M-Verduzco/ClockMachineryInCAD/(list of files, cad)

Other CAD files:
01_Sub_10_11_12.prt
10_Ball.prt
11_Bow.prt
12_BowPivot.prt
13_HingeSection.prt
14_HourTube.prt
15_HourPivot.prt
16_WinderPivot.prt
19_SmallShaftCap.prt
1_PendulumPivot.prt
20_SmallShaftCap-Flatted.prt
21_Shaft.prt
22_HingePivot.prt
23_PawlPin.prt
24_HourHand.prt
25_MinuteHand.prt
26_Weight.prt
27_GearSpacer.prt
28_Hanger.prt
29_Winder.prt
2_PendulumRod.prt
31_Drum.prt
32_Ratchet.prt
33_Pawl.prt
34_Shaft.prt
35_RatchetPivot.prt
36_Shaft.prt
37_Escapement.prt
38_Yoke.prt
39_EscapementWheel.prt
3_PendulumHead.prt
40_GearSpacer.prt
41_Gear.prt
42_DoorCatch.prt
43_Gear.prt
44_Gear.prt
45_Gear.prt
46_Gear.prt
47_Gear.prt
48_Gear.prt
49_Gear.prt
4_PendulumBob.prt
50_Gear.prt
51_Gear.prt
52_HangerSpacer.prt
53_HangerSpacerBottom.prt
5_PendulumHead.prt
5_PendulumNut.prt
6_Case.prt
7_Door.prt
8_BaseBoard.prt
9_FrontBoard (1).prt
Sub_pendulo.prt
