M-Verduzco/ClockMachineryInCAD/Planos Originales.pdf

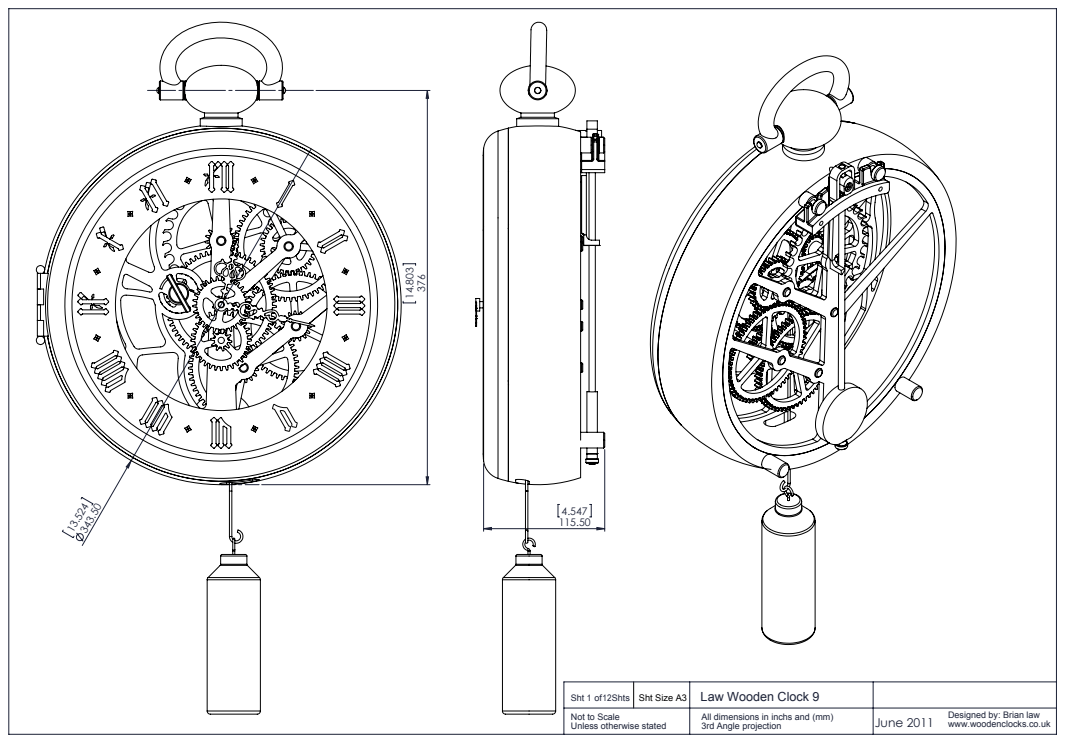
[picture p17: page 1]

1 12 Sht of Shts | Sht Size A3 | Law Wooden Clock 9
Not to Scale Unless otherwise stated | | All dimensions in inchs and (mm) 3rd Angle projection | Designed by: Brian law June 2011 www.woodenclocks.co.uk

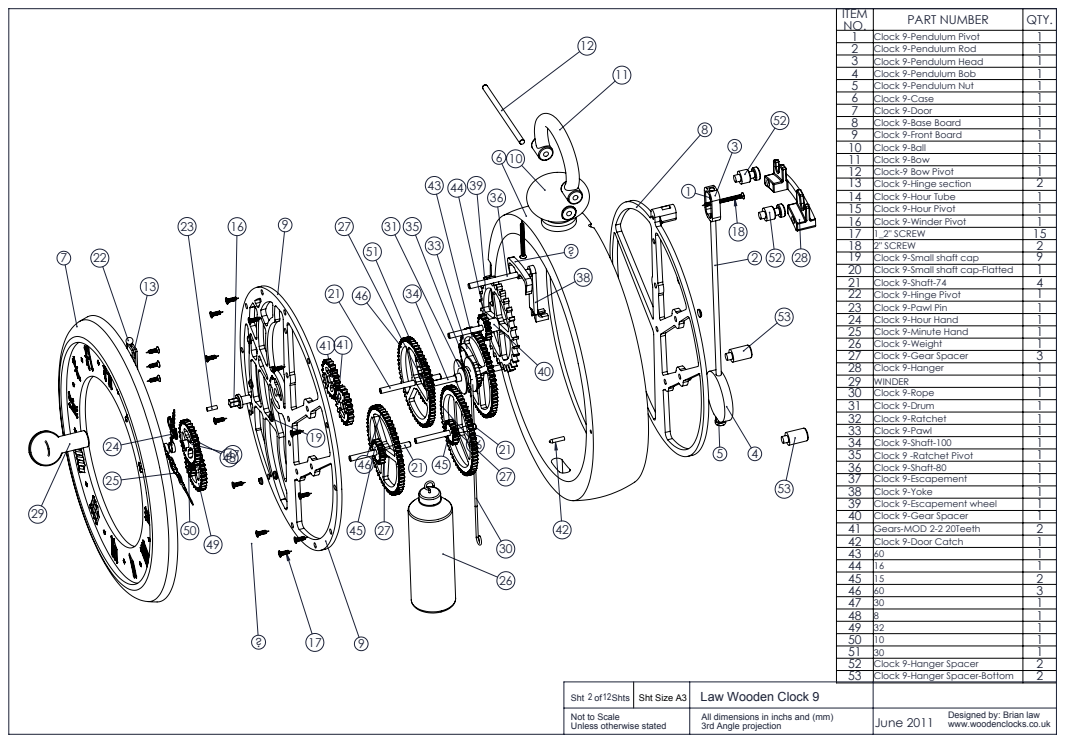
[picture p18: page 2]
PART NUMBER; QTY. 1; Clock 9-Pendulum Pivot; Clock 9-Pendulum Rod; Clock 9-Pendulum Head; Clock 9-Pendulum Bob; Clock 9-Pendulum Nut; Clock 9-Case; Clock 9-Door; Clock 9-Base Board; Clock 9-Front Board

10 | Clock 9-Ball | 1
11 | Clock 9-Bow | 1
12 | Clock-9 Bow Pivot | 1
13 | Clock 9-Hinge section | 2
14 | Clock 9-Hour Tube | 1
15 | Clock 9-Hour Pivot | 1
16 | Clock 9-Winder Pivot | 1
17 | 1_2" SCREW | 15
18 | 2" SCREW | 2
19 | Clock 9-Small shaft cap | 9
20 | Clock 9-Small shaft cap-Flatted | 1
21 | Clock 9-Shaft-74 | 4
22 | Clock 9-Hinge Pivot | 1
23 | Clock 9-Pawl Pin | 1
24 | Clock 9-Hour Hand | 1
25 | Clock 9-Minute Hand | 1
26 | Clock 9-Weight | 1
27 | Clock 9-Gear Spacer | 3
28 | Clock 9-Hanger | 1
29 | WINDER | 1
30 | Clock 9-Rope | 1
31 | Clock 9-Drum | 1
32 | Clock 9-Ratchet | 1
33 | Clock 9-Pawl | 1
34 | Clock 9-Shaft-100 | 1
35 | Clock 9 -Ratchet Pivot | 1
36 | Clock 9-Shaft-80 | 1
37 | Clock 9-Escapement | 1
38 | Clock 9-Yoke | 1
39 | Clock 9-Escapement wheel | 1
40 | Clock 9-Gear Spacer | 1
41 | Gears-MOD 2-2 20Teeth | 2
42 | Clock 9-Door Catch | 1

43 | 60 | 1
44 | 16 | 1
45 | 15 | 2
46 | 60 | 3
47 | 30 | 1
48 | 8 | 1
49 | 32 | 1
50 | 10 | 1
51 | 30 | 1
52 | Clock 9-Hanger Spacer | 2
53 | Clock 9-Hanger Spacer-Bottom | 2

2 12 | | Law Wooden Clock 9

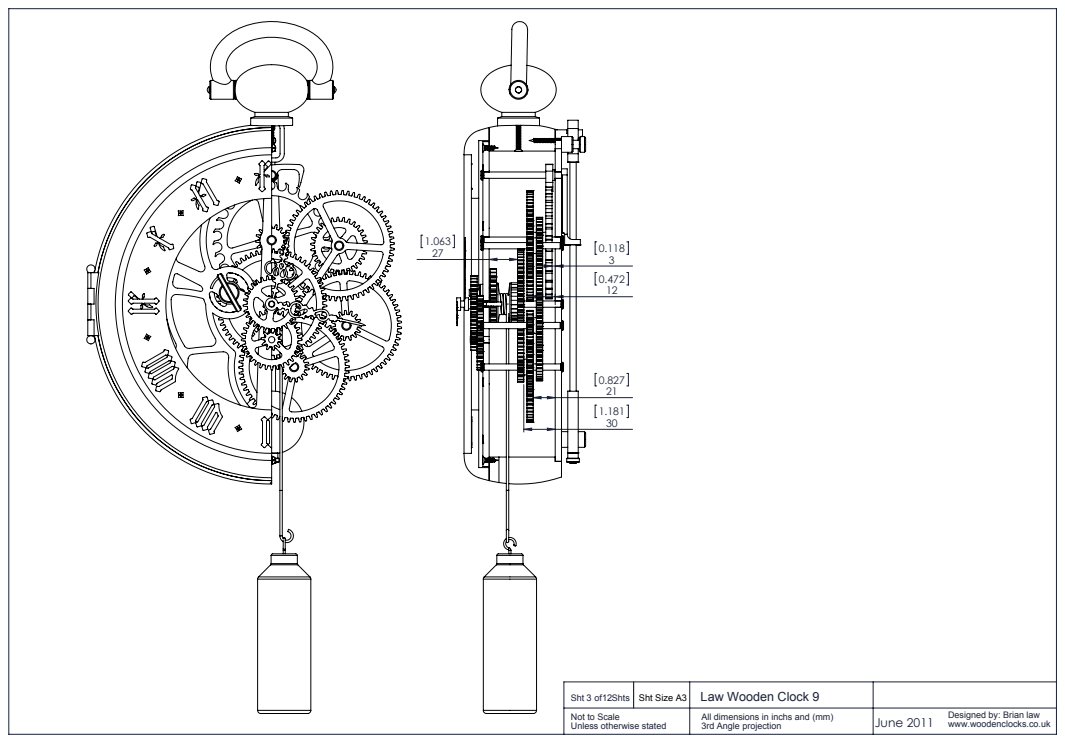
[picture p19: page 3]
Law Wooden Clock 9

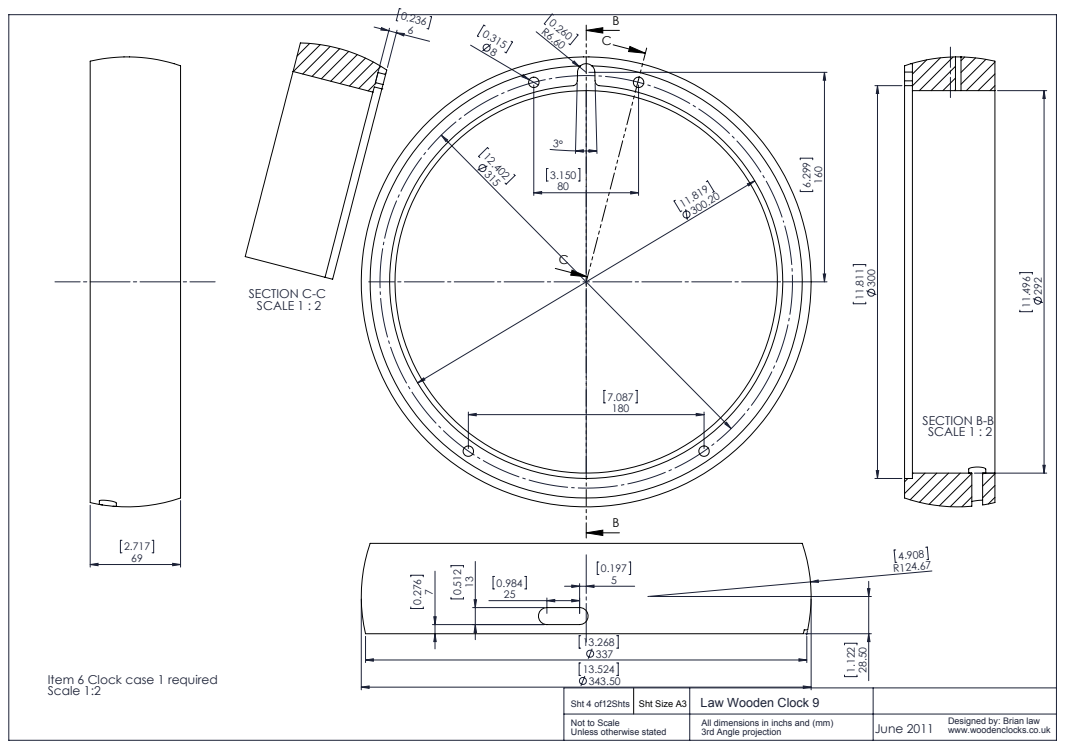
[picture p20: page 4]
SECTION B-B SCALE 1 : 2; SECTION C-C SCALE 1 : 2; Law Wooden Clock 9

Item 6 Clock case 1 required
Scale 1:2

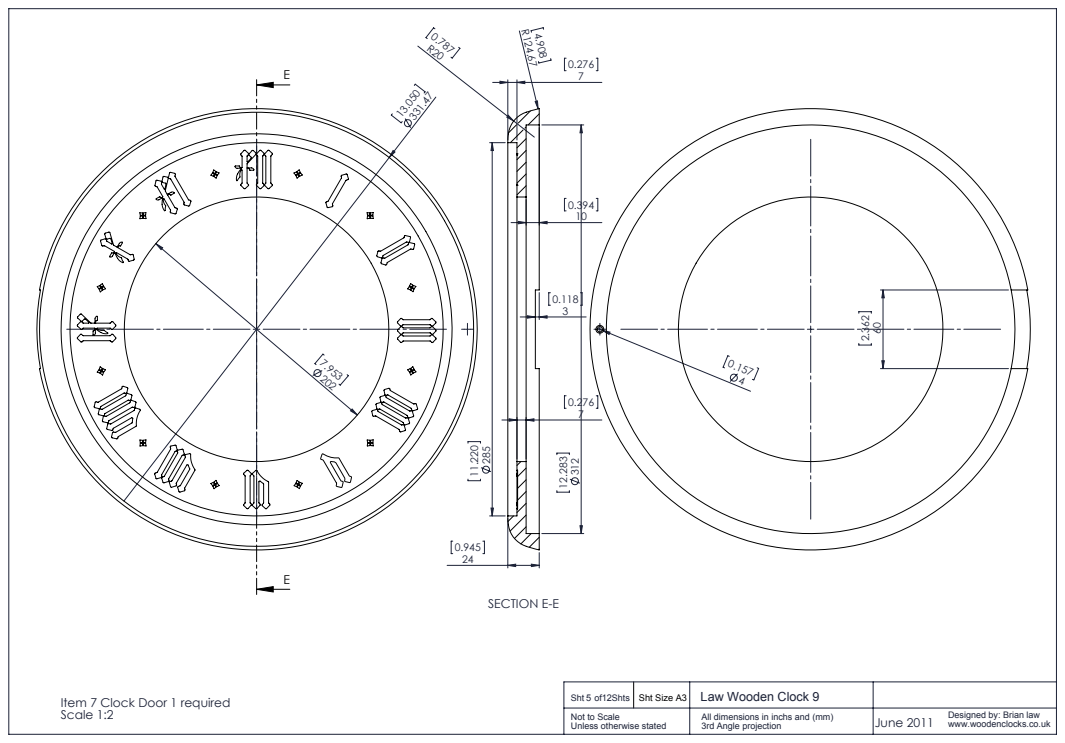
[picture p21: page 5]
SECTION E-E; Law Wooden Clock 9

Item 7 Clock Door 1 required
Scale 1:2

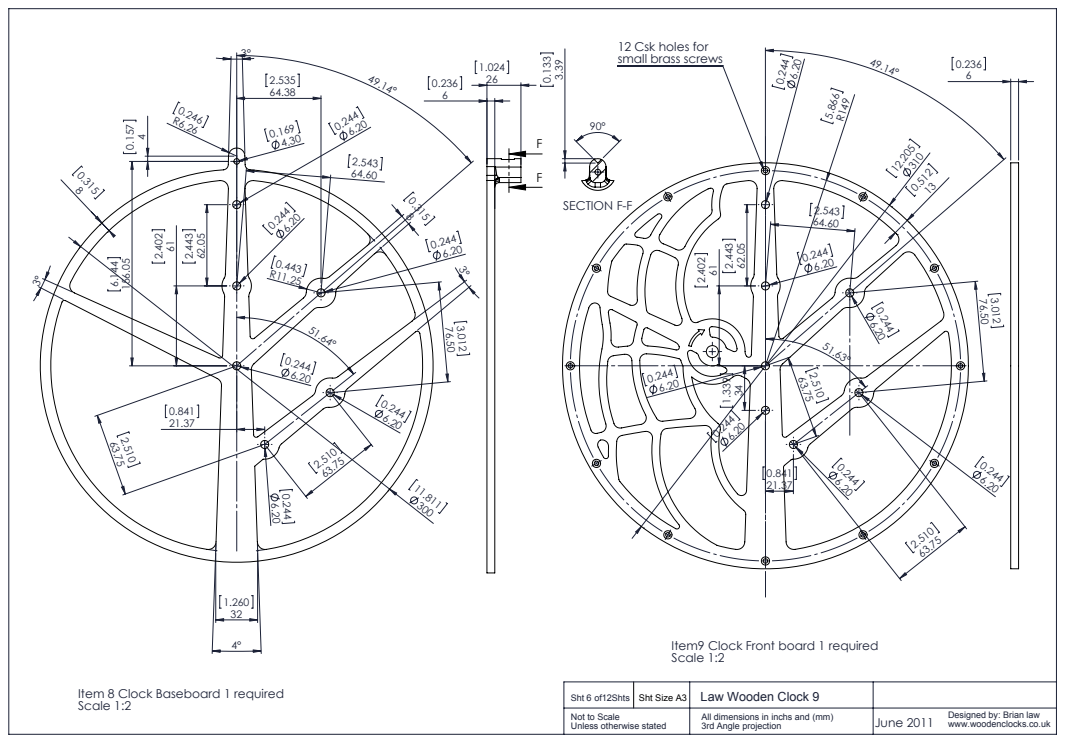
[picture p22: page 6]
SECTION F-F; small brass screws; Law Wooden Clock 9

12 Csk holes for

Item9 Clock Front board 1 required
Scale 1:2

Item 8 Clock Baseboard 1 required

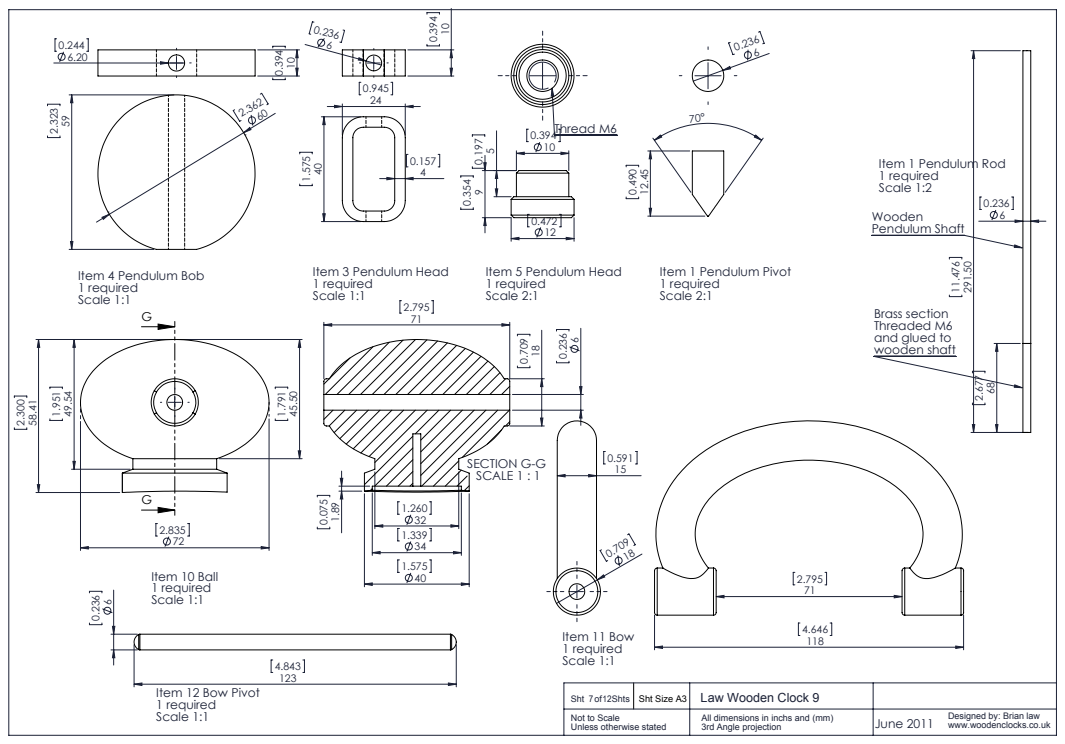
[picture p23: page 7]
Thread M6; SECTION G-G SCALE 1 : 1; Item 10 Ball 1 required Scale 1:1; Item 11 Bow 1 required Scale 1:1

Item 1 Pendulum Rod
1 required
Scale 1:2
Wooden
Pendulum Shaft

Item 4 Pendulum Bob
Scale 1:1

Item 3 Pendulum Head

Item 5 Pendulum Head
Scale 2:1

Item 1 Pendulum Pivot

Brass section
Threaded M6
and glued to
wooden shaft

7 12 Item 12 Bow Pivot

Law Wooden Clock 9

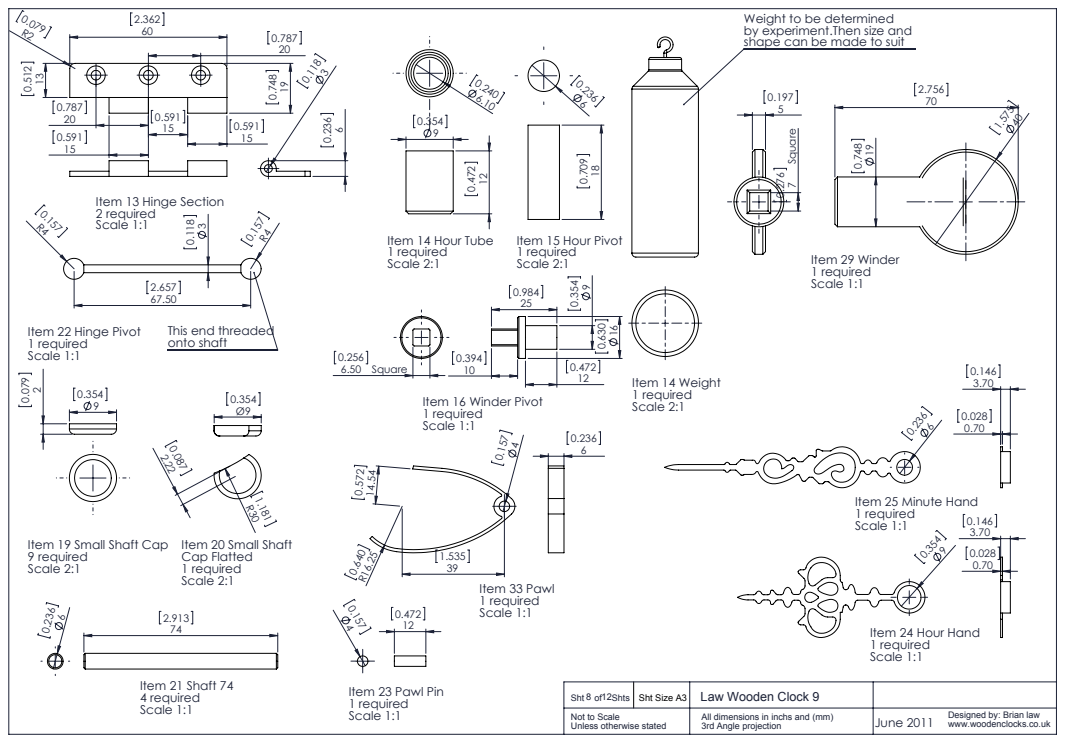
[picture p24: page 8]
This end threaded onto shaft; 6.50 Square; Item 21 Shaft 74 4 required; Item 14 Weight 1 required Scale 2:1; Item 29 Winder 1 required Scale 1:1; 7 Square; Item 16 Winder Pivot 1 required Scale 1:1; Scale 2:1; Item 33 Pawl; 1 required Scale 1:1; Law Wooden Clock 9

Weight to be determined
by experiment.Then size and
shape can be made to suit

Item 13 Hinge Section
2 required
Scale 1:1

Item 14 Hour Tube
1 required
Scale 2:1

Item 15 Hour Pivot

Item 22 Hinge Pivot

Item 25 Minute Hand

Item 19 Small Shaft Cap
9 required

Item 20 Small Shaft
Cap Flatted

Item 24 Hour Hand

Item 23 Pawl Pin

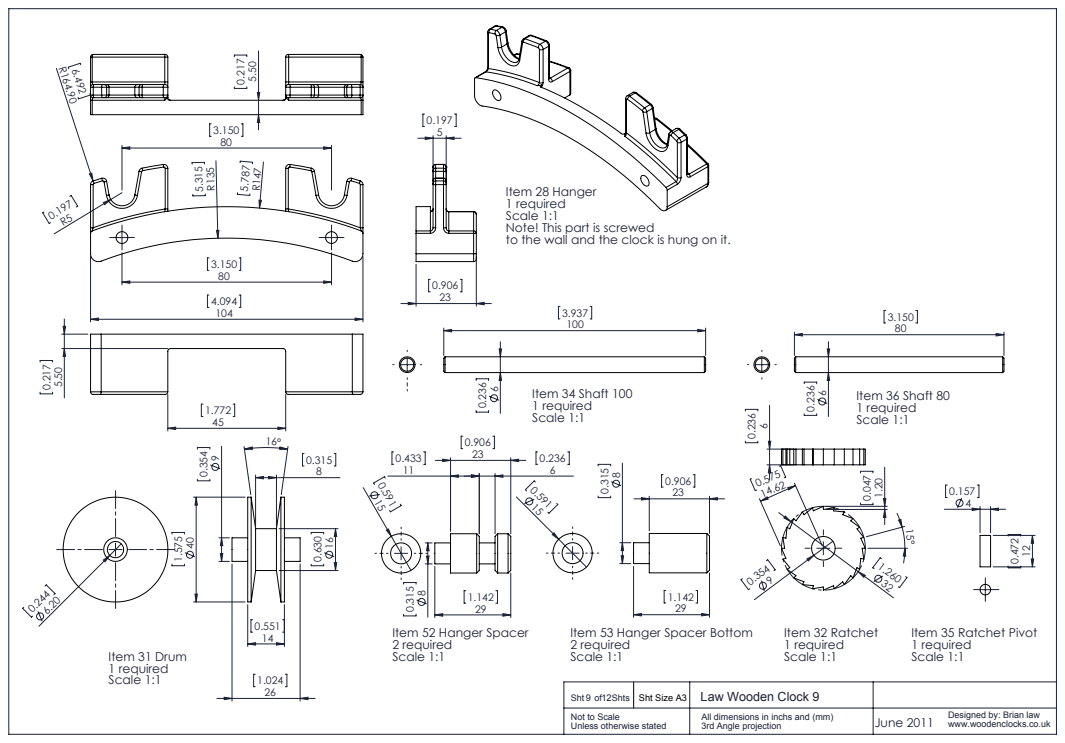
[picture p25: page 9]
Item 34 Shaft 100 1 required Scale 1:1; Item 36 Shaft 80 1 required Scale 1:1; Item 31 Drum 1 required Scale 1:1; Item 32 Ratchet 1 required Scale 1:1; Law Wooden Clock 9

Item 28 Hanger
1 required
Scale 1:1
Note! This part is screwed
to the wall and the clock is hung on it.

Item 52 Hanger Spacer
2 required

Item 53 Hanger Spacer Bottom

Item 35 Ratchet Pivot

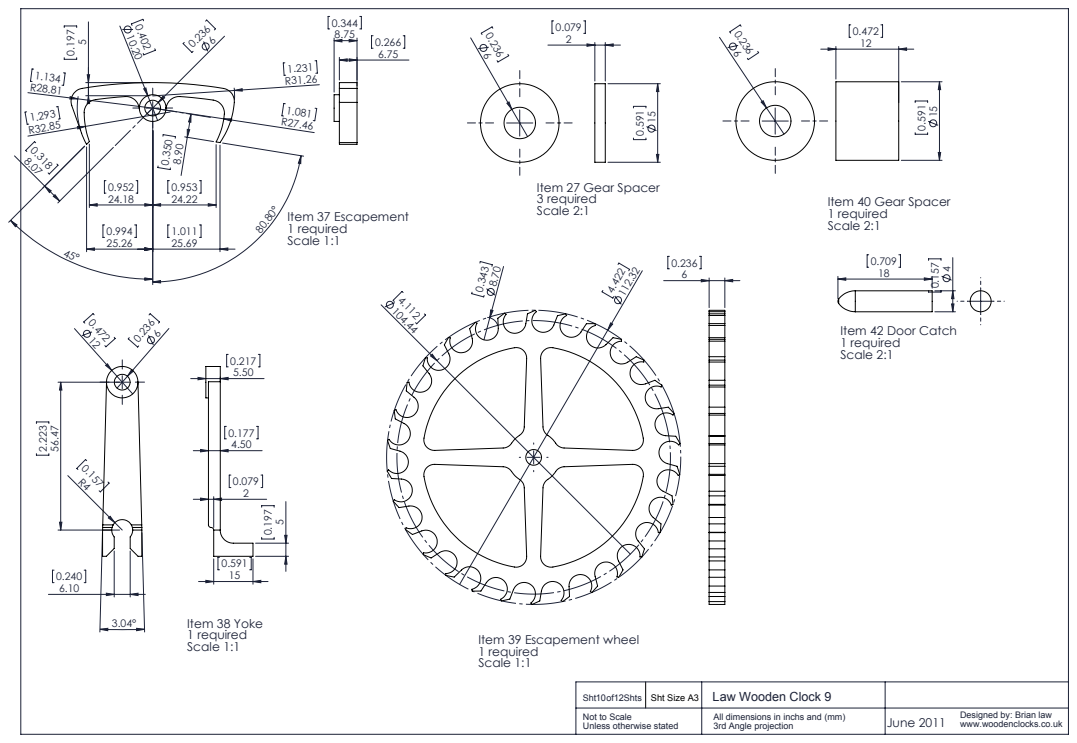
[picture p26: page 10]
Item 37 Escapement 1 required Scale 1:1; Item 38 Yoke 1 required Scale 1:1

Item 27 Gear Spacer
3 required
Scale 2:1

Item 40 Gear Spacer
1 required

Item 42 Door Catch

Item 39 Escapement wheel
Scale 1:1

Law Wooden Clock 9

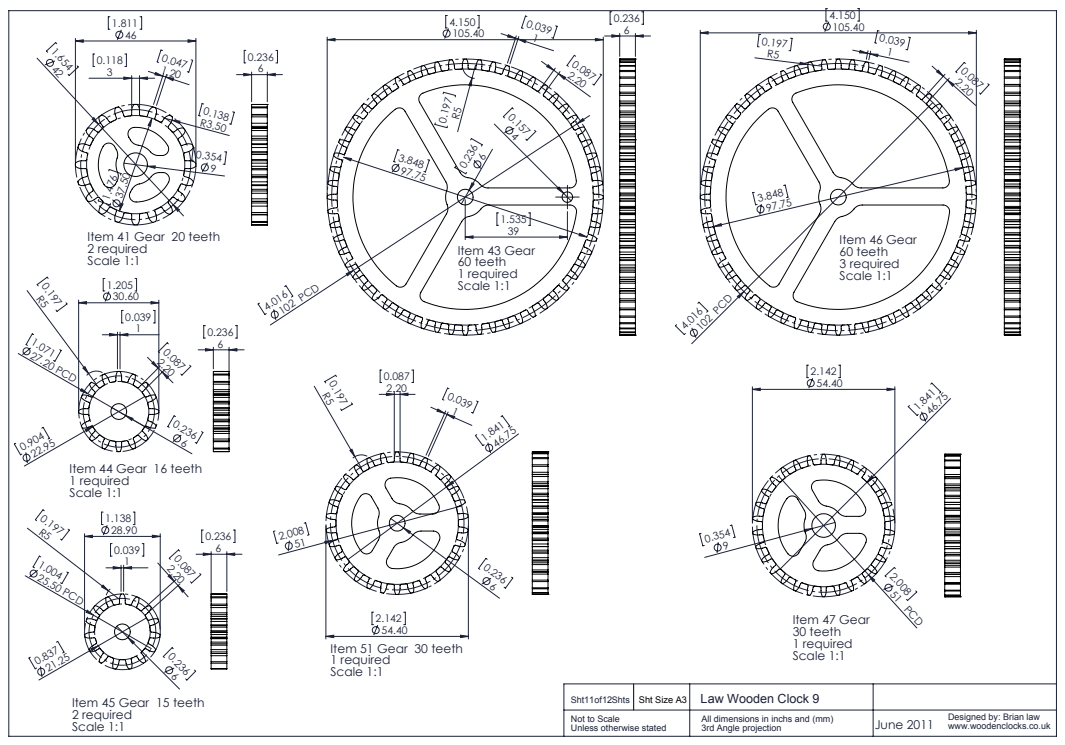
[picture p27: page 11]
Item 41 Gear 20 teeth 2 required Scale 1:1; 102 PCD; Item 43 Gear 60 teeth 1 required Scale 1:1; 27.20 PCD; 25.50 PCD; Item 47 Gear 30 teeth 1 required Scale 1:1; Item 46 Gear 60 teeth 3 required Scale 1:1; Item 44 Gear 16 teeth 1 required Scale 1:1; Law Wooden Clock 9

Item 51 Gear 30 teeth
1 required
Scale 1:1

Item 45 Gear 15 teeth
2 required

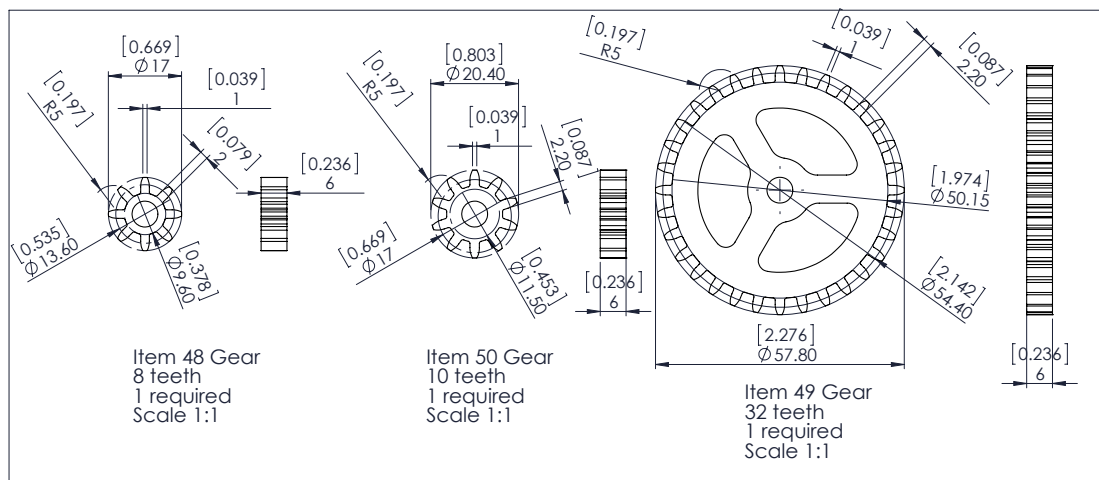
[picture p28: page 12]
Item 48 Gear 8 teeth 1 required Scale 1:1; Item 50 Gear 10 teeth 1 required Scale 1:1; Item 49 Gear 32 teeth 1 required Scale 1:1; Law Wooden Clock 9
